emericarhantdev/micro_ROSbot/Specific_symbols_and_footprints/Bulk_polarized_Capacitors/LIB_TCJB227M006R0070/TCJB227M006R0070/3D/TCJB227M006R0070.stp

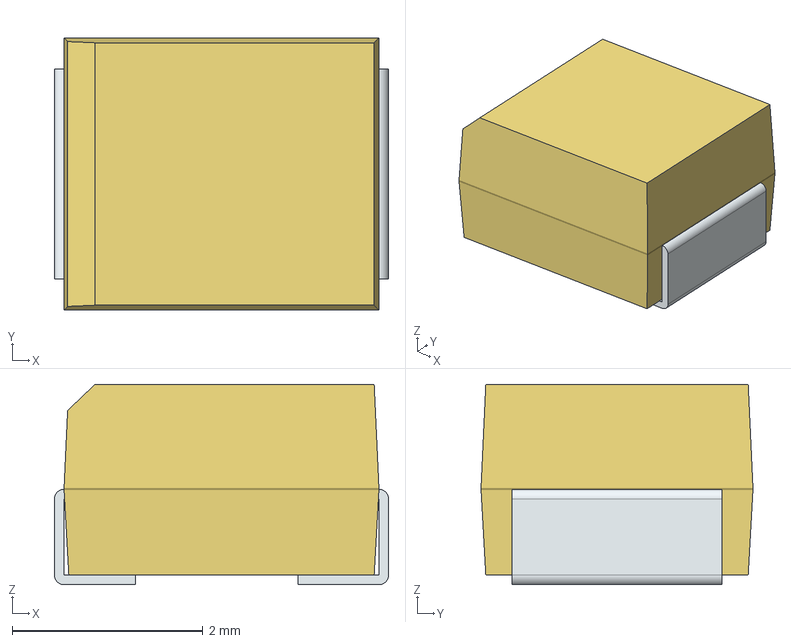
[picture p3: CAD file, 2026-02-18]
Specific_symbols_and_footprints/Bulk_polarized_Capacitors/LIB_TCJB227M006R0070/TCJB227M006R0070/3D/TCJB227M006R0070.stp
3.50 x 2.85 x 2.10 mm
FilletPin1
FilletPin2
