emericarhantdev/micro_ROSbot/Specific_symbols_and_footprints/Buzzers/LIB_CMT-0525-75-SMT-TR/CMT-0525-75-SMT-TR/3D/CMT-0525-75-SMT-TR.stp

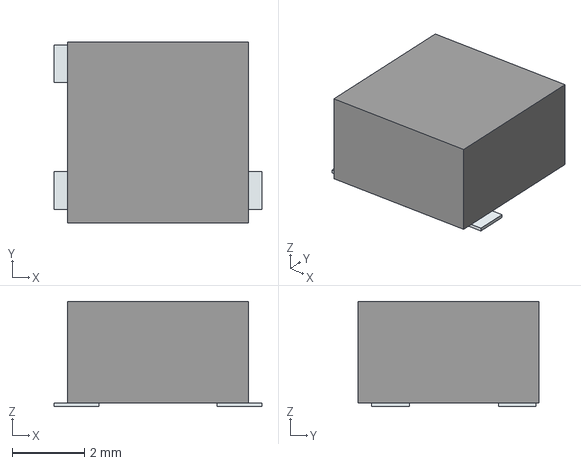
[picture p4: CAD file, 2026-02-18]
Specific_symbols_and_footprints/Buzzers/LIB_CMT-0525-75-SMT-TR/CMT-0525-75-SMT-TR/3D/CMT-0525-75-SMT-TR.stp
5.74 x 5.00 x 2.90 mm
Pins
