emericarhantdev/micro_ROSbot/Specific_symbols_and_footprints/esp32/LIB_ESP32-S3-WROOM-1-N16R8/ESP32-S3-WROOM-1-N16R8/3D/ESP32-S3-WROOM-1-N16R8.stp

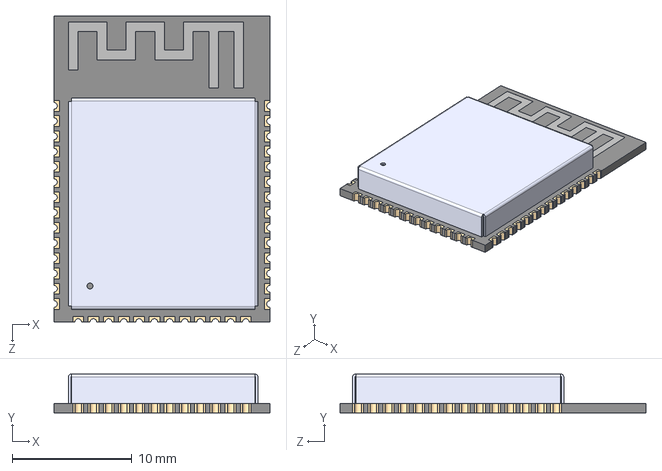
[picture p5: CAD file, 2026-02-18]
Specific_symbols_and_footprints/esp32/LIB_ESP32-S3-WROOM-1-N16R8/ESP32-S3-WROOM-1-N16R8/3D/ESP32-S3-WROOM-1-N16R8.stp
18.0 x 3.25 x 25.5 mm
