emericarhantdev/micro_ROSbot/Specific_symbols_and_footprints/IMUs/LIB_MPU-6050/MPU-6050/3D/MPU-6050.stp

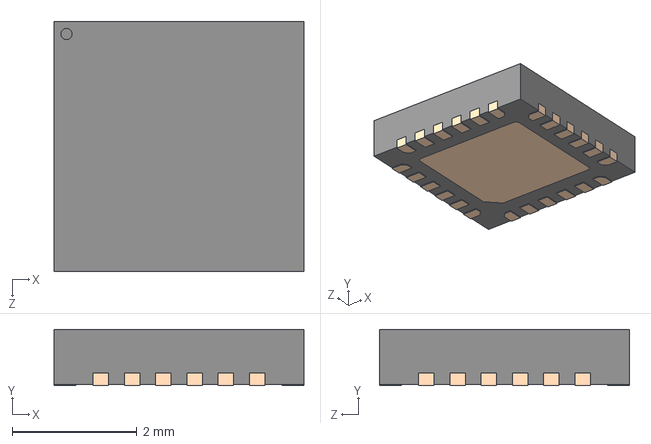
[picture p6: CAD file, 2026-02-18]
Specific_symbols_and_footprints/IMUs/LIB_MPU-6050/MPU-6050/3D/MPU-6050.stp
4.00 x 0.9 x 4.00 mm
