emericarhantdev/micro_ROSbot/Specific_symbols_and_footprints/IR_emiters/LIB_TSAL6200/TSAL6200/3D/TSAL6200.stp

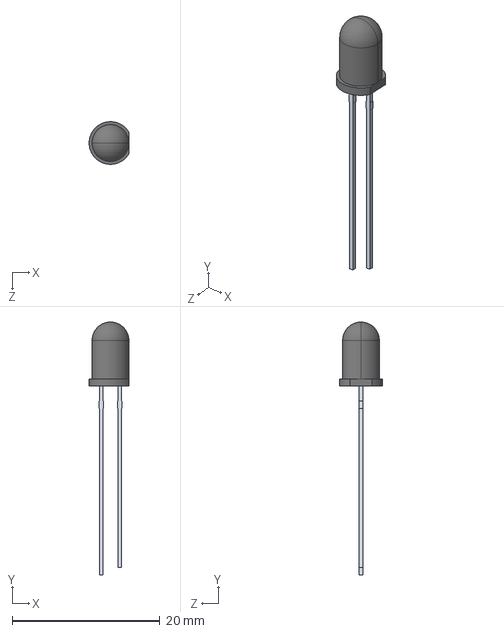
[picture p7: CAD file, 2026-02-18]
Specific_symbols_and_footprints/IR_emiters/LIB_TSAL6200/TSAL6200/3D/TSAL6200.stp
5.40 x 34.3 x 5.79 mm
