emericarhantdev/micro_ROSbot/Specific_symbols_and_footprints/LEDs/LIB_ASCKCG00-NW5X5020302/ASCKCG00-NW5X5020302/3D/ASCKCG00-NW5X5020302.stp

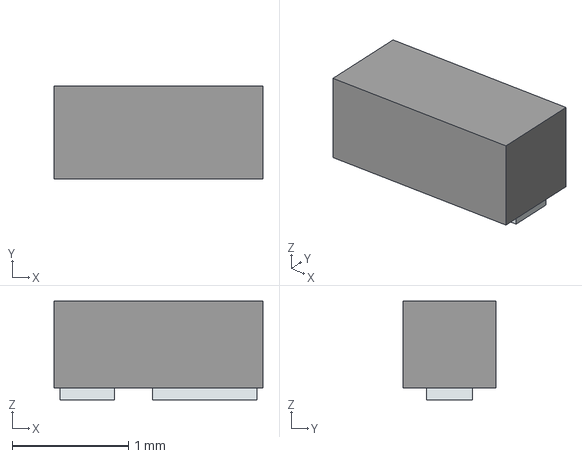
[picture p8: CAD file, 2026-02-18]
Specific_symbols_and_footprints/LEDs/LIB_ASCKCG00-NW5X5020302/ASCKCG00-NW5X5020302/3D/ASCKCG00-NW5X5020302.stp
1.80 x 0.8 x 0.85 mm
Pins
