emericarhantdev/micro_ROSbot/Specific_symbols_and_footprints/Mosfet_transistor/LIB_DMN3065LW-7/DMN3065LW-7/3D/DMN3065LW-7.stp

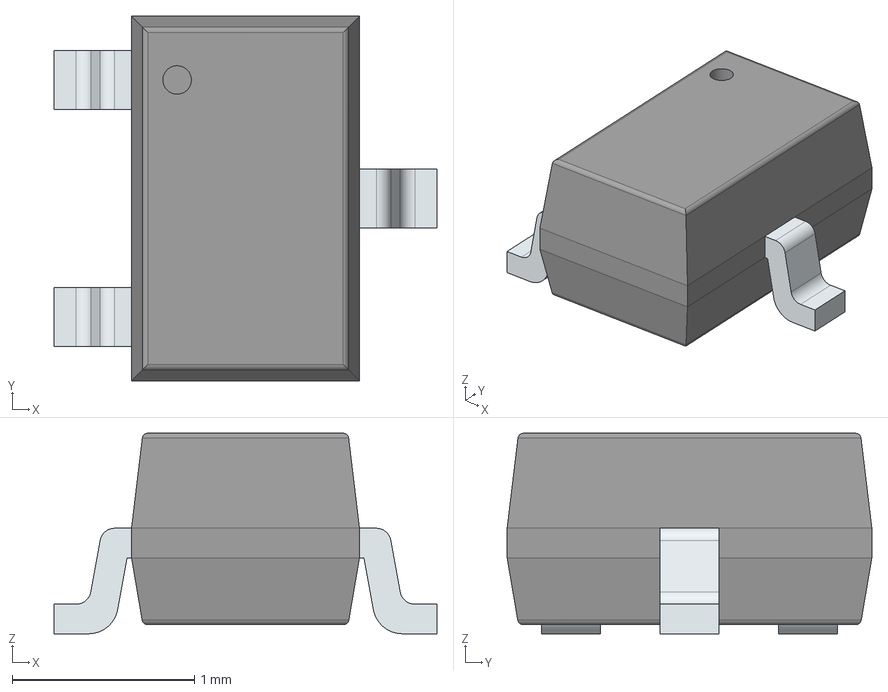
[picture p9: CAD file, 2026-02-18]
Specific_symbols_and_footprints/Mosfet_transistor/LIB_DMN3065LW-7/DMN3065LW-7/3D/DMN3065LW-7.stp
2.10 x 2.00 x 1.10 mm
PinsArrayL
FilletPinR
