emericarhantdev/micro_ROSbot/Specific_symbols_and_footprints/motor_drivers/LIB_TB6612FNG,C,8,EL/TB6612FNG,C,8,EL/3D/TB6612FNG,C,8,EL.stp

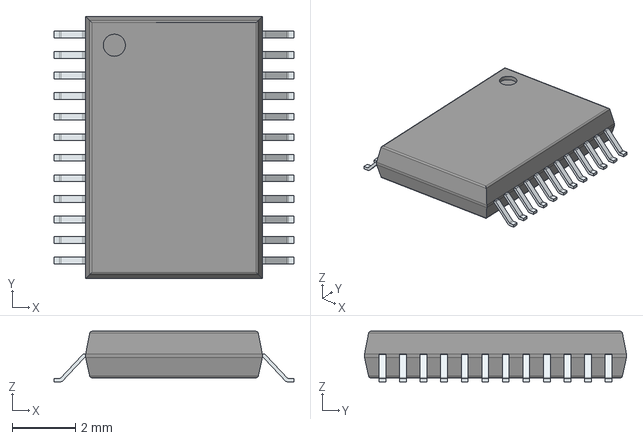
[picture p10: CAD file, 2026-02-18]
Specific_symbols_and_footprints/motor_drivers/LIB_TB6612FNG,C,8,EL/TB6612FNG,C,8,EL/3D/TB6612FNG,C,8,EL.stp
7.60 x 8.30 x 1.60 mm
PinsArrayLR
