emericarhantdev/micro_ROSbot/Specific_symbols_and_footprints/Push_buttons/PTS810SJG250SMTRLFS.stp

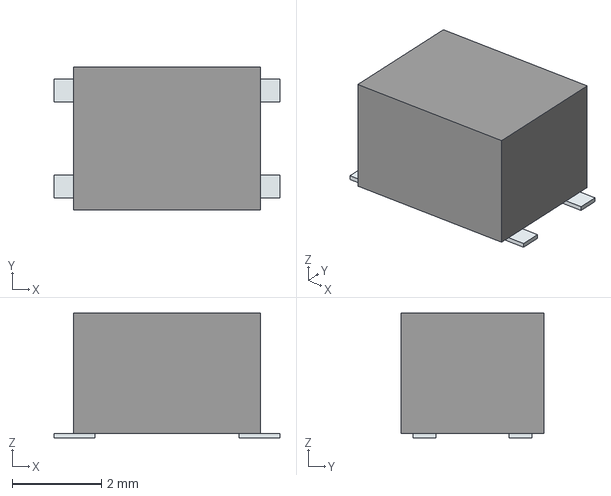
[picture p11: CAD file, 2026-02-18]
Specific_symbols_and_footprints/Push_buttons/PTS810SJG250SMTRLFS.stp
5.07 x 3.20 x 2.80 mm
Pins
