emericarhantdev/micro_ROSbot/Specific_symbols_and_footprints/relays/LIB_IMB03ITS/IMB03ITS/3D/IMB03ITS.stp

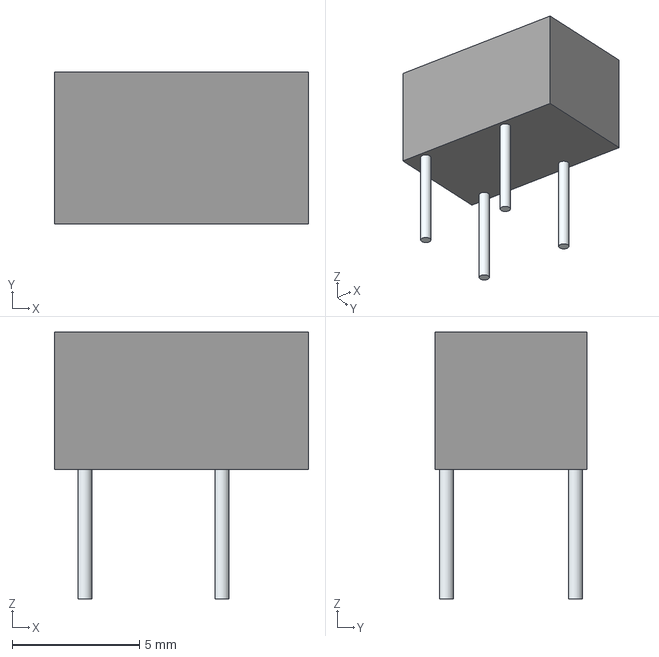
[picture p12: CAD file, 2026-02-18]
Specific_symbols_and_footprints/relays/LIB_IMB03ITS/IMB03ITS/3D/IMB03ITS.stp
10.0 x 6.00 x 10.5 mm
Leads
