emericarhantdev/micro_ROSbot/Specific_symbols_and_footprints/shottky_diodes/LIB_BAT20JFILM/BAT20JFILM/3D/BAT20JFILM.stp

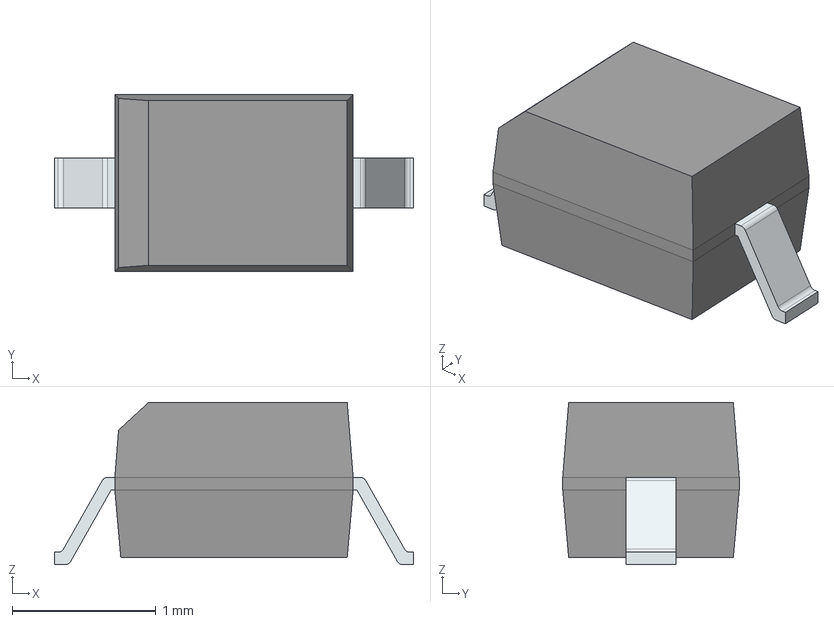
[picture p13: CAD file, 2026-02-18]
Specific_symbols_and_footprints/shottky_diodes/LIB_BAT20JFILM/BAT20JFILM/3D/BAT20JFILM.stp
2.50 x 1.23 x 1.13 mm
FilletPinL
FilletPinR
