emericarhantdev/micro_ROSbot/Specific_symbols_and_footprints/Switch_buttons/LIB_SS312SAH4/SS312SAH4/3D/SS312SAH4.stp

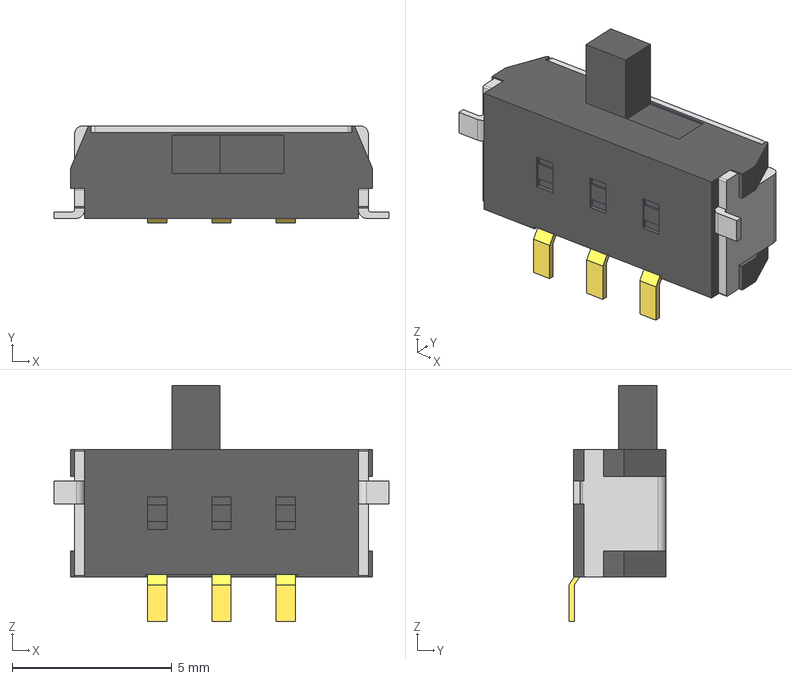
[picture p14: CAD file, 2026-02-18]
Specific_symbols_and_footprints/Switch_buttons/LIB_SS312SAH4/SS312SAH4/3D/SS312SAH4.stp
10.5 x 3.05 x 7.39 mm
SS312SAH4body
SS312SAH4actu
SS312SAH4trmnls
SS312SAH4brac
