emericarhantdev/micro_ROSbot/Specific_symbols_and_footprints/Test_hooks/LIB_S2751-46R/S2751-46R/3D/S2751-46R.stp

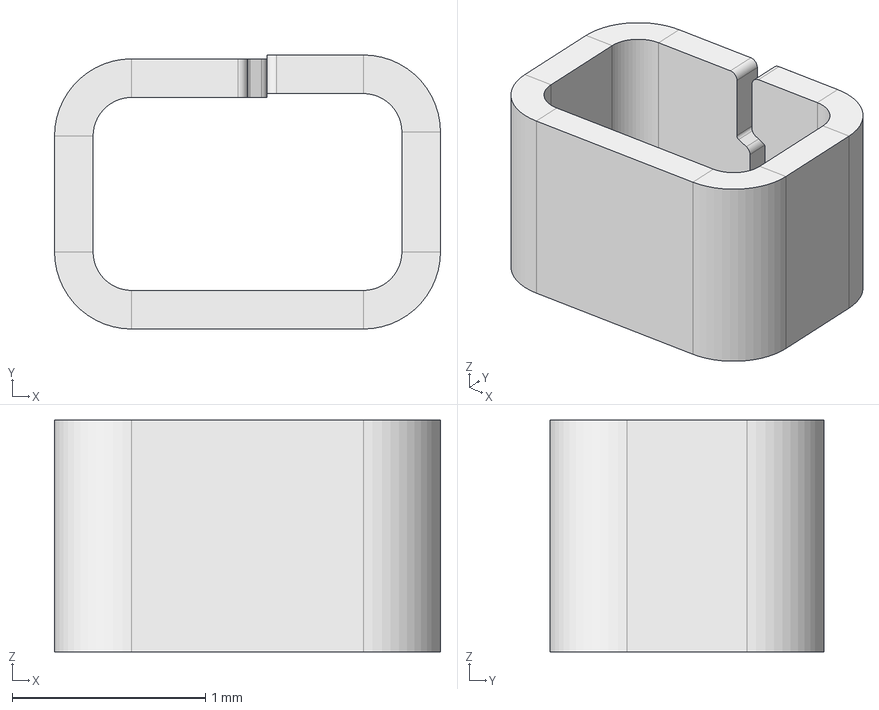
[picture p15: CAD file, 2026-02-18]
Specific_symbols_and_footprints/Test_hooks/LIB_S2751-46R/S2751-46R/3D/S2751-46R.stp
2.00 x 1.42 x 1.20 mm
