emericarhantdev/micro_ROSbot/Specific_symbols_and_footprints/USB_dongles/LIB_USB3075-30-A/USB3075-30-A/3D/USB3075-30-A.stp

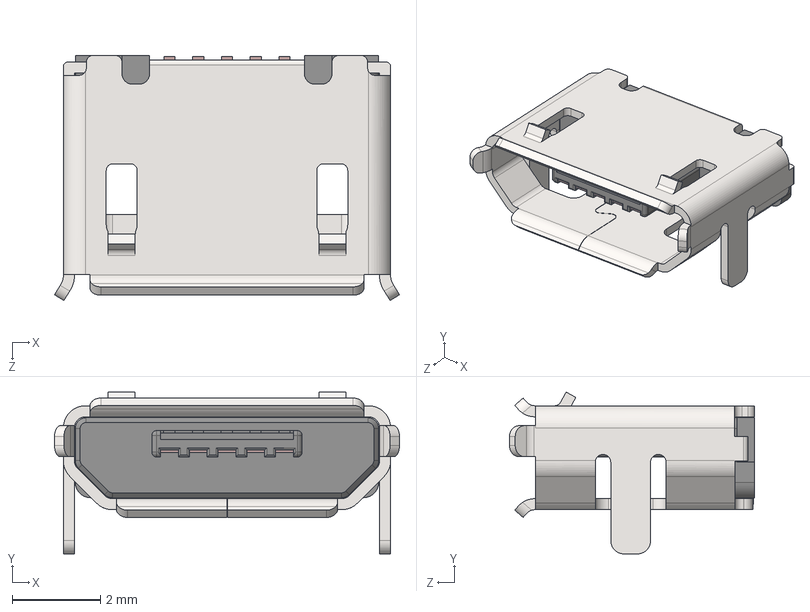
[picture p16: CAD file, 2026-02-18]
Specific_symbols_and_footprints/USB_dongles/LIB_USB3075-30-A/USB3075-30-A/3D/USB3075-30-A.stp
7.80 x 3.66 x 5.54 mm
