emericarhantdev/micro_ROSbot/Specific_symbols_and_footprints/voltage_regulators/LIB_TLV76701DGNR/TLV76701DGNR/3D/TLV76701DGNR.stp

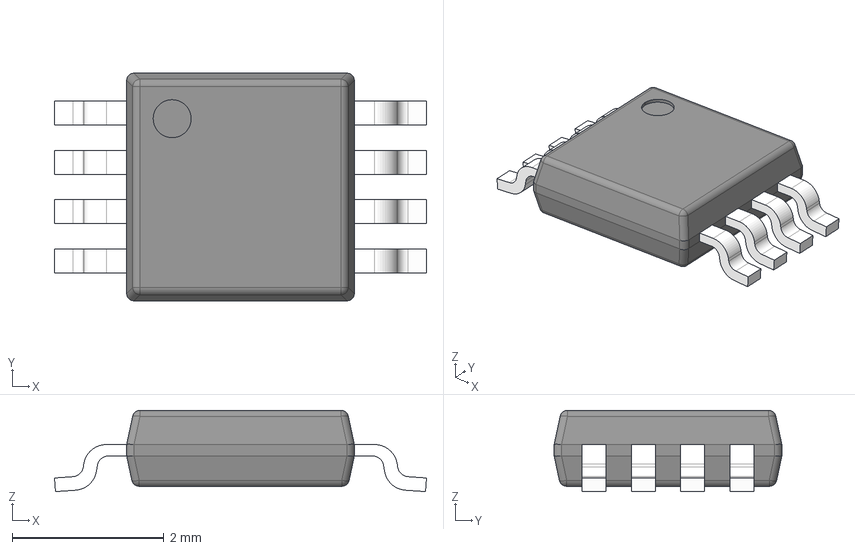
[picture p17: CAD file, 2026-02-18]
Specific_symbols_and_footprints/voltage_regulators/LIB_TLV76701DGNR/TLV76701DGNR/3D/TLV76701DGNR.stp
4.90 x 3.00 x 1.07 mm
BODY-DGN0008G
LEAD-DGN0008G x 8
PIN1_DGN0008G
DAP_DGN0008G
