emericarhantdev/micro_ROSbot/(list of files, cad)

Other CAD files:
Specific_symbols_and_footprints/Bulk_polarized_Capacitors/LIB_TCJB227M006R0070/TCJB227M006R0070/Allegro/cappm3528x210n.psm
Specific_symbols_and_footprints/Bulk_polarized_Capacitors/LIB_TCJB227M006R0070/TCJB227M006R0070/DEHDL/tcjb227m006r0070/chips/chips.prt
Specific_symbols_and_footprints/Buzzers/LIB_CMT-0525-75-SMT-TR/CMT-0525-75-SMT-TR/Allegro/cmt052575smttr.psm
Specific_symbols_and_footprints/Buzzers/LIB_CMT-0525-75-SMT-TR/CMT-0525-75-SMT-TR/DEHDL/cmt_0525_75_smt_tr/chips/chips.prt
Specific_symbols_and_footprints/IMUs/LIB_MPU-6050/MPU-6050/Allegro/mpu6050.psm
Specific_symbols_and_footprints/IMUs/LIB_MPU-6050/MPU-6050/DEHDL/mpu_6050/chips/chips.prt
Specific_symbols_and_footprints/IR_emiters/LIB_TSAL6200/TSAL6200/Allegro/tsal6200.psm
Specific_symbols_and_footprints/IR_emiters/LIB_TSAL6200/TSAL6200/DEHDL/tsal6200/chips/chips.prt
Specific_symbols_and_footprints/LEDs/LIB_ASCKCG00-NW5X5020302/ASCKCG00-NW5X5020302/Allegro/asckcg00nw5x5020302.psm
Specific_symbols_and_footprints/LEDs/LIB_ASCKCG00-NW5X5020302/ASCKCG00-NW5X5020302/DEHDL/asckcg00_nw5x5020302/chips/chips.prt
Specific_symbols_and_footprints/Mosfet_transistor/LIB_DMN3065LW-7/DMN3065LW-7/Allegro/sot65p210x110-3n.psm
Specific_symbols_and_footprints/Mosfet_transistor/LIB_DMN3065LW-7/DMN3065LW-7/DEHDL/dmn3065lw_7/chips/chips.prt
Specific_symbols_and_footprints/Push_buttons/LIB_PTS810SJM250SMTRLFS/PTS810SJM250SMTRLFS/Allegro/pts810sjg250smtrlfs.psm
Specific_symbols_and_footprints/Push_buttons/LIB_PTS810SJM250SMTRLFS/PTS810SJM250SMTRLFS/DEHDL/pts810sjm250smtrlfs/chips/chips.prt
Specific_symbols_and_footprints/Switch_buttons/LIB_SS312SAH4/SS312SAH4/Allegro/ss312sah4.psm
Specific_symbols_and_footprints/Switch_buttons/LIB_SS312SAH4/SS312SAH4/DEHDL/ss312sah4/chips/chips.prt
Specific_symbols_and_footprints/Test_hooks/LIB_S2751-46R/S2751-46R/Allegro/s275146r.psm
Specific_symbols_and_footprints/Test_hooks/LIB_S2751-46R/S2751-46R/DEHDL/s2751_46r/chips/chips.prt
Specific_symbols_and_footprints/USB_dongles/LIB_USB3075-30-A/USB3075-30-A/Allegro/usb307530a.psm
Specific_symbols_and_footprints/USB_dongles/LIB_USB3075-30-A/USB3075-30-A/DEHDL/usb3075_30_a/chips/chips.prt
Specific_symbols_and_footprints/esp32/LIB_ESP32-S3-WROOM-1-N16R8/ESP32-S3-WROOM-1-N16R8/Allegro/esp32s3wroom1n16r8.psm
Specific_symbols_and_footprints/esp32/LIB_ESP32-S3-WROOM-1-N16R8/ESP32-S3-WROOM-1-N16R8/DEHDL/esp32_s3_wroom_1_n16r8/chips/chips.prt
Specific_symbols_and_footprints/motor_drivers/LIB_TB6612FNG,C,8,EL/TB6612FNG,C,8,EL/Allegro/sop65p760x160-24n.psm
Specific_symbols_and_footprints/motor_drivers/LIB_TB6612FNG,C,8,EL/TB6612FNG,C,8,EL/DEHDL/tb6612fng_c_8_el/chips/chips.prt
Specific_symbols_and_footprints/relays/LIB_IMB03ITS/IMB03ITS/Allegro/imb03its.psm
Specific_symbols_and_footprints/relays/LIB_IMB03ITS/IMB03ITS/DEHDL/imb03its/chips/chips.prt
Specific_symbols_and_footprints/shottky_diodes/LIB_BAT20JFILM/BAT20JFILM/Allegro/sod2512x113n.psm
Specific_symbols_and_footprints/shottky_diodes/LIB_BAT20JFILM/BAT20JFILM/DEHDL/bat20jfilm/chips/chips.prt
Specific_symbols_and_footprints/voltage_regulators/LIB_TLV76701DGNR/TLV76701DGNR/Allegro/sop65p490x110-9n.psm
Specific_symbols_and_footprints/voltage_regulators/LIB_TLV76701DGNR/TLV76701DGNR/DEHDL/tlv76701dgnr/chips/chips.prt
