emericarhantdev/micro_ROSbot/PAMI-Power_Board.kicad_pcb

## KiCad design PAMI-Power_Board.kicad_pcb (2026-02-18)

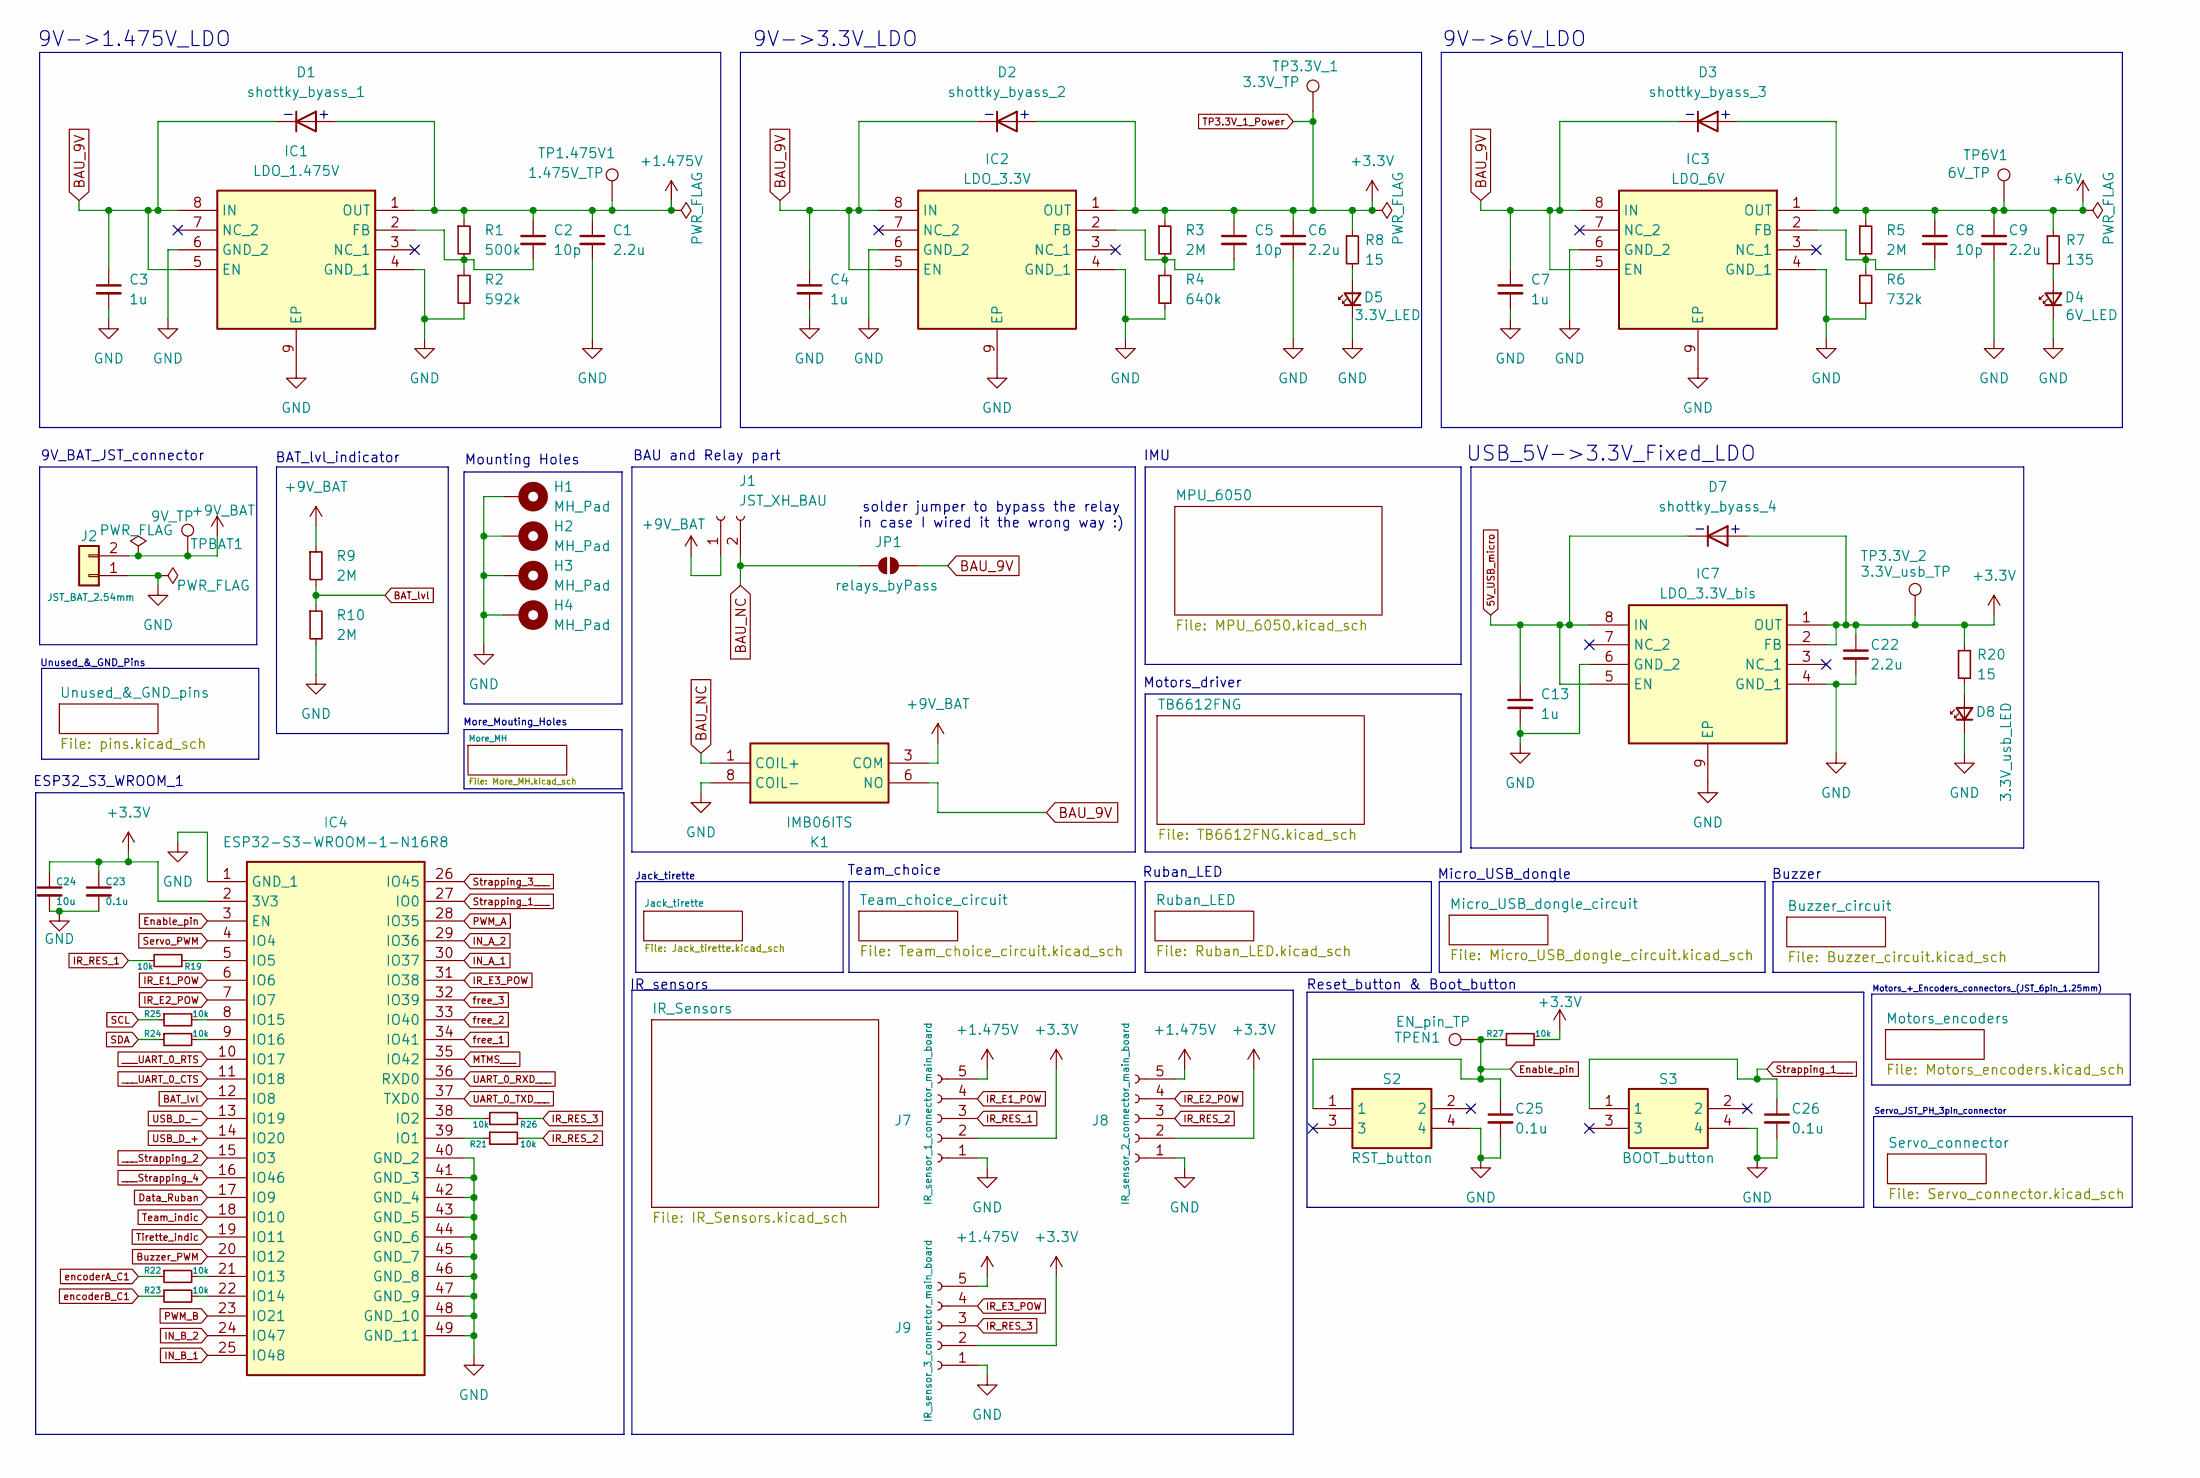
[picture p18: schematic PAMI-Power_Board.kicad_sch]

Parts:
C1, C6, C9, C22: 2.2u; C_0805_2012Metric_Pad1.18x1.45mm_HandSolder
C2, C5, C8: 10p; C_0805_2012Metric_Pad1.18x1.45mm_HandSolder
C3, C4, C7, C13: 1u; C_0805_2012Metric_Pad1.18x1.45mm_HandSolder
C23, C25, C26: 0.1u; C_0805_2012Metric_Pad1.18x1.45mm_HandSolder
C24: 10u; C_0805_2012Metric_Pad1.18x1.45mm_HandSolder
D1: shottky_byass_1; SOD2512X113N
D2: shottky_byass_2; SOD2512X113N
D3: shottky_byass_3; SOD2512X113N
D4: 6V_LED; ASCKCG00NW5X5020302
D5: 3.3V_LED; ASCKCG00NW5X5020302
D7: shottky_byass_4; SOD2512X113N
D8: 3.3V_usb_LED; ASCKCG00NW5X5020302
H1, H2, H3, H4: MH_Pad; MountingHole_2.2mm_M2_Pad_Via
IC1: LDO_1.475V; SOP65P490X110-9N; Manufacturer_Part_Number TLV76701DGNR; Mouser Part Number 595-TLV76701DGNR
IC2: LDO_3.3V; SOP65P490X110-9N; Manufacturer_Part_Number TLV76701DGNR; Mouser Part Number 595-TLV76701DGNR
IC3: LDO_6V; SOP65P490X110-9N; Manufacturer_Part_Number TLV76701DGNR; Mouser Part Number 595-TLV76701DGNR
IC4: ESP32-S3-WROOM-1-N16R8; ESP32S3WROOM1N16R8; Manufacturer_Part_Number ESP32-S3-WROOM-1-N16R8; Mouser Part Number 356-ESP32S3WRM1N16R8
IC7: LDO_3.3V_bis; SOP65P490X110-9N; Manufacturer_Part_Number TLV76701DGNR; Mouser Part Number 595-TLV76701DGNR
J1: JST_XH_BAU; JST_XH_B2B-XH-A_1x02_P2.50mm_Vertical
J2: JST_BAT_2.54mm; JST_XH_B2B-XH-A_1x02_P2.50mm_Vertical
J7: IR_sensor_1_connector_main_board; JST_ZH_1x05_P1.50mm_Vertical
J8: IR_sensor_2_connector_main_board; JST_ZH_1x05_P1.50mm_Vertical
J9: IR_sensor_3_connector_main_board; JST_ZH_1x05_P1.50mm_Vertical
JP1: relays_byPass; SolderJumper-2_P1.3mm_Open_Pad1.0x1.5mm
K1: IMB06ITS; IMB03ITS; Manufacturer_Part_Number IMB03ITS; Mouser Part Number 655-IMB03ITS
R1: 500k; R_0805_2012Metric_Pad1.20x1.40mm_HandSolder
R2: 592k; R_0805_2012Metric_Pad1.20x1.40mm_HandSolder
R3, R5, R9, R10: 2M; R_0805_2012Metric_Pad1.20x1.40mm_HandSolder
R4: 640k; R_0805_2012Metric_Pad1.20x1.40mm_HandSolder
R6: 732k; R_0805_2012Metric_Pad1.20x1.40mm_HandSolder
R7: 135; R_0805_2012Metric_Pad1.20x1.40mm_HandSolder
R8, R20: 15; R_0805_2012Metric_Pad1.20x1.40mm_HandSolder
R19, R21, R22, R23, R24, R25, R26, R27: 10k; R_0805_2012Metric_Pad1.20x1.40mm_HandSolder
S2: RST_button; PTS810SJG250SMTRLFS; Manufacturer_Part_Number PTS810SJM250SMTRLFS; Mouser Part Number 611-PTS810SJM250SMTR
S3: BOOT_button; PTS810SJG250SMTRLFS; Manufacturer_Part_Number PTS810SJM250SMTRLFS; Mouser Part Number 611-PTS810SJM250SMTR
TP1.475V1: 1.475V_TP; S275146R
TP3.3V_1: 3.3V_TP; S275146R
TP3.3V_2: 3.3V_usb_TP; S275146R
TP6V1: 6V_TP; S275146R
TPBAT1: 9V_TP; S275146R
TPEN1: EN_pin_TP; S275146R

Connections:
5V_USB_micro: C13.1, D7.1 (K), IC7.5 (EN), IC7.8 (IN); also elsewhere on the board
+1.475V: C1.1, C2.1, D1.2 (A), IC1.1 (OUT), J7.5, J8.5, J9.5, R1.1, TP1.475V1.1; also elsewhere on the board
+6V: C8.1, C9.1, D3.2 (A), IC3.1 (OUT), R5.1, R7.1, TP6V1.1; also elsewhere on the board
+9V_BAT: J1.1, J2.2, K1.3 (COM), R9.1, TPBAT1.1
BAT_lvl: IC4.12 (IO8), R9.2, R10.1
BAU_9V: C3.1, C4.1, C7.1, D1.1 (K), D2.1 (K), D3.1 (K), IC1.5 (EN), IC1.8 (IN), IC2.5 (EN), IC2.8 (IN), IC3.5 (EN), IC3.8 (IN), JP1.2 (B), K1.6 (NO)
BAU_NC: J1.2, JP1.1 (A), K1.1 (COIL+)
Buzzer_PWM: IC4.20 (IO12); also elsewhere on the board
Data_Ruban: IC4.17 (IO9); also elsewhere on the board
Enable_pin: C25.1, IC4.3 (EN), R27.1, S2.1, TPEN1.1
GND: C1.2, C3.2, C4.2, C6.2, C7.2, C9.2, C13.2, C22.2, C23.2, C24.2, C25.2, C26.2, D4.1 (K), D5.1 (K), D8.1 (K), H1.1, H2.1, H3.1, H4.1, IC1.4 (GND_1), IC1.6 (GND_2), IC1.9 (EP), IC2.4 (GND_1), IC2.6 (GND_2), IC2.9 (EP), IC3.4 (GND_1), IC3.6 (GND_2), IC3.9 (EP), IC4.1 (GND_1), IC4.40 (GND_2), IC4.41 (GND_3), IC4.42 (GND_4), IC4.43 (GND_5), IC4.44 (GND_6), IC4.45 (GND_7), IC4.46 (GND_8), IC4.47 (GND_9), IC4.48 (GND_10), IC4.49 (GND_11), IC7.4 (GND_1), IC7.6 (GND_2), IC7.9 (EP), J2.1, J7.1, J8.1, J9.1, K1.8 (COIL-), R2.2, R4.2, R6.2, R10.2, S2.4, S3.4; also elsewhere on the board
IN_A_1: IC4.30 (IO37); also elsewhere on the board
IN_A_2: IC4.29 (IO36); also elsewhere on the board
IN_B_1: IC4.25 (IO48); also elsewhere on the board
IN_B_2: IC4.24 (IO47); also elsewhere on the board
IR_E1_POW: IC4.6 (IO6), J7.4; also elsewhere on the board
IR_E2_POW: IC4.7 (IO7), J8.4; also elsewhere on the board
IR_E3_POW: IC4.31 (IO38), J9.4; also elsewhere on the board
IR_RES_1: J7.3, R19.2; also elsewhere on the board
IR_RES_2: J8.3, R21.2; also elsewhere on the board
IR_RES_3: J9.3, R26.1; also elsewhere on the board
MTMS___: IC4.35 (IO42); also elsewhere on the board
unnamed: D4.2 (A), R7.2
unnamed: D5.2 (A), R8.2
unnamed: D8.2 (A), R20.2
unnamed: C2.2, IC1.2 (FB), R1.2, R2.1
unnamed: C5.2, IC2.2 (FB), R3.2, R4.1
unnamed: C8.2, IC3.2 (FB), R5.2, R6.1
unnamed: IC4.39 (IO1), R21.1
unnamed: IC4.38 (IO2), R26.2
unnamed: IC4.5 (IO5), R19.1
unnamed: IC4.21 (IO13), R22.2
unnamed: IC4.22 (IO14), R23.2
unnamed: IC4.8 (IO15), R25.2
unnamed: IC4.9 (IO16), R24.2
PWM_A: IC4.28 (IO35); also elsewhere on the board
PWM_B: IC4.23 (IO21); also elsewhere on the board
SCL: R25.1; also elsewhere on the board
SDA: R24.1; also elsewhere on the board
Servo_PWM: IC4.4 (IO4); also elsewhere on the board
Strapping_1___: C26.1, IC4.27 (IO0), S3.1
Strapping_3___: IC4.26 (IO45); also elsewhere on the board
TP3.3V_1_Power: C5.1, C6.1, C22.1, C23.1, C24.1, D2.2 (A), D7.2 (A), IC2.1 (OUT), IC4.2 (3V3), IC7.1 (OUT), IC7.2 (FB), J7.2, J8.2, J9.2, R3.1, R8.1, R20.1, R27.2, TP3.3V_1.1, TP3.3V_2.1; also elsewhere on the board
Team_indic: IC4.18 (IO10); also elsewhere on the board
Tirette_indic: IC4.19 (IO11); also elsewhere on the board
UART_0_RXD___: IC4.36 (RXD0); also elsewhere on the board
UART_0_TXD___: IC4.37 (TXD0); also elsewhere on the board
USB_D_+: IC4.14 (IO20); also elsewhere on the board
USB_D_-: IC4.13 (IO19); also elsewhere on the board
___Strapping_2: IC4.15 (IO3); also elsewhere on the board
___Strapping_4: IC4.16 (IO46); also elsewhere on the board
___UART_0_CTS: IC4.11 (IO18); also elsewhere on the board
___UART_0_RTS: IC4.10 (IO17); also elsewhere on the board
encoderA_C1: R22.1; also elsewhere on the board
encoderB_C1: R23.1; also elsewhere on the board
free_1: IC4.34 (IO41); also elsewhere on the board
free_2: IC4.33 (IO40); also elsewhere on the board
free_3: IC4.32 (IO39); also elsewhere on the board

Notes on the sheet:
9V->6V_LDO
Motors_driver
USB_5V->3.3V_Fixed_LDO
Servo_JST_PH_3pin_connector
solder jumper to bypass the relay in case I wired it the wrong way :)
Ruban_LED
BAU and Relay part
IR_sensors
9V->1.475V_LDO
IMU
9V_BAT_JST_connector
Team_choice
ESP32_S3_WROOM_1
Jack_tirette
Motors_+_Encoders_connectors_(JST_6pin_1.25mm)
Mounting Holes
9V->3.3V_LDO
Micro_USB_dongle
BAT_lvl_indicator
Buzzer
More_Mouting_Holes
Unused_&_GND_Pins
Reset_button & Boot_button

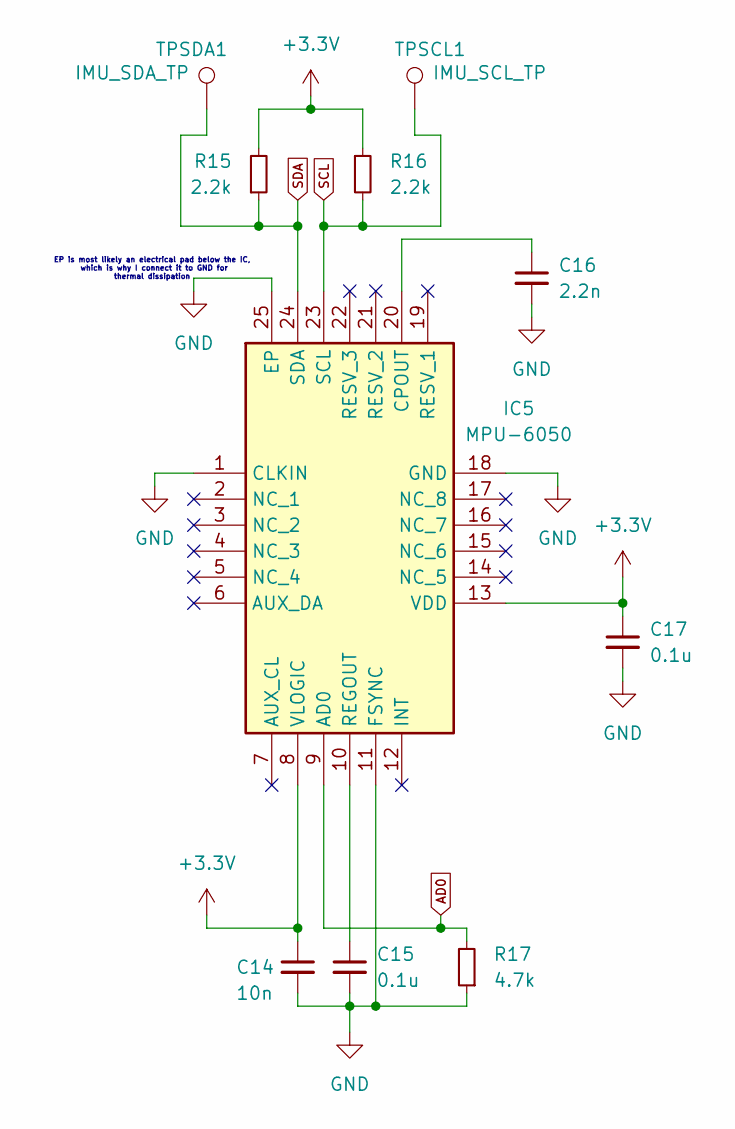
[picture p19: schematic MPU_6050.kicad_sch]

Parts:
C14: 10n; C_0805_2012Metric_Pad1.18x1.45mm_HandSolder
C15, C17: 0.1u; C_0805_2012Metric_Pad1.18x1.45mm_HandSolder
C16: 2.2n; C_0805_2012Metric_Pad1.18x1.45mm_HandSolder
IC5: MPU-6050; MPU6050; Manufacturer_Part_Number MPU-6050; Mouser Part Number 410-MPU-6050
R15, R16: 2.2k; R_0805_2012Metric_Pad1.20x1.40mm_HandSolder
R17: 4.7k; R_0805_2012Metric_Pad1.20x1.40mm_HandSolder
TPSCL1: IMU_SCL_TP; S275146R
TPSDA1: IMU_SDA_TP; S275146R

Connections:
AD0: IC5.9 (AD0), R17.2
GND: C14.2, C15.2, C16.2, C17.2, IC5.1 (CLKIN), IC5.11 (FSYNC), IC5.18 (GND), IC5.25 (EP), R17.1; also elsewhere on the board
unnamed: C16.1, IC5.20 (CPOUT)
unnamed: C15.1, IC5.10 (REGOUT)
SCL: IC5.23 (SCL), R16.2, TPSCL1.1; also elsewhere on the board
SDA: IC5.24 (SDA), R15.1, TPSDA1.1; also elsewhere on the board
TP3.3V_1_Power: C14.1, C17.1, IC5.8 (VLOGIC), IC5.13 (VDD), R15.2, R16.1; also elsewhere on the board

Notes on the sheet:
EP is most likely an electrical pad below the IC, which is why I connect it to GND for thermal dissipation

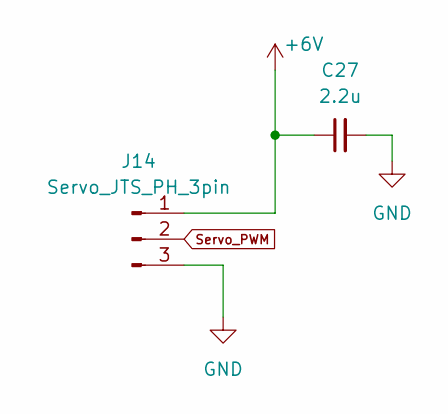
[picture p20: schematic Servo_connector.kicad_sch]

Parts:
C27: 2.2u; C_0805_2012Metric_Pad1.18x1.45mm_HandSolder
J14: Servo_JTS_PH_3pin; JST_PH_B3B-PH-K_1x03_P2.00mm_Vertical

Connections:
+6V: C27.1, J14.1; also elsewhere on the board
GND: C27.2, J14.3; also elsewhere on the board
Servo_PWM: J14.2; also elsewhere on the board

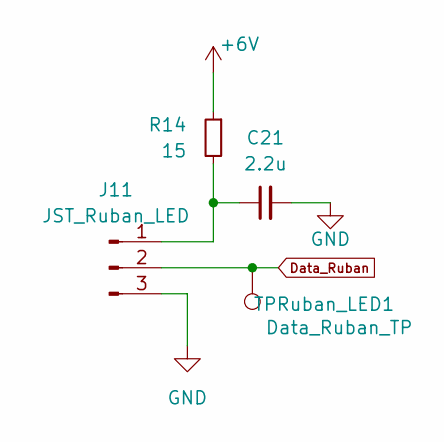
[picture p21: schematic Ruban_LED.kicad_sch]

Parts:
C21: 2.2u; C_0805_2012Metric_Pad1.18x1.45mm_HandSolder
J11: JST_Ruban_LED; JST_PH_B3B-PH-K_1x03_P2.00mm_Vertical
R14: 15; R_0805_2012Metric_Pad1.20x1.40mm_HandSolder
TPRuban_LED1: Data_Ruban_TP; S275146R

Connections:
+6V: R14.1; also elsewhere on the board
Data_Ruban: J11.2, TPRuban_LED1.1; also elsewhere on the board
GND: C21.2, J11.3; also elsewhere on the board
unnamed: C21.1, J11.1, R14.2

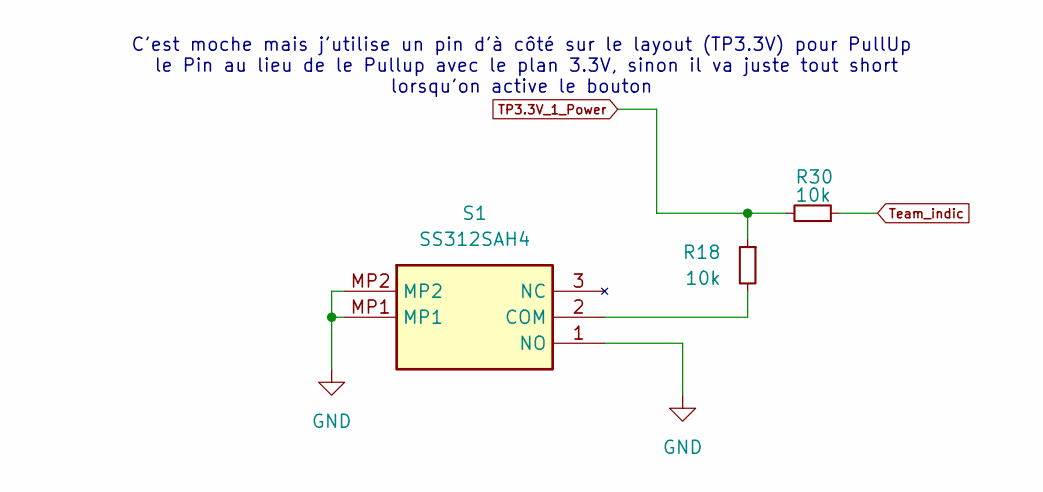
[picture p22: schematic Team_choice_circuit.kicad_sch]

Parts:
R18, R30: 10k; R_0805_2012Metric_Pad1.20x1.40mm_HandSolder
S1: SS312SAH4; Manufacturer_Part_Number SS312SAH4; Mouser Part Number 633-SS312SAH4

Connections:
GND: S1.1 (NO), S1.MP1, S1.MP2; also elsewhere on the board
unnamed: R18.2, S1.2 (COM)
TP3.3V_1_Power: R18.1, R30.2; also elsewhere on the board
Team_indic: R30.1; also elsewhere on the board

Notes on the sheet:
C'est moche mais j'utilise un pin d'à côté sur le layout (TP3.3V) pour PullUp le Pin au lieu de le Pullup avec le plan 3.3V, sinon il va juste tout short lorsqu'on active le bouton

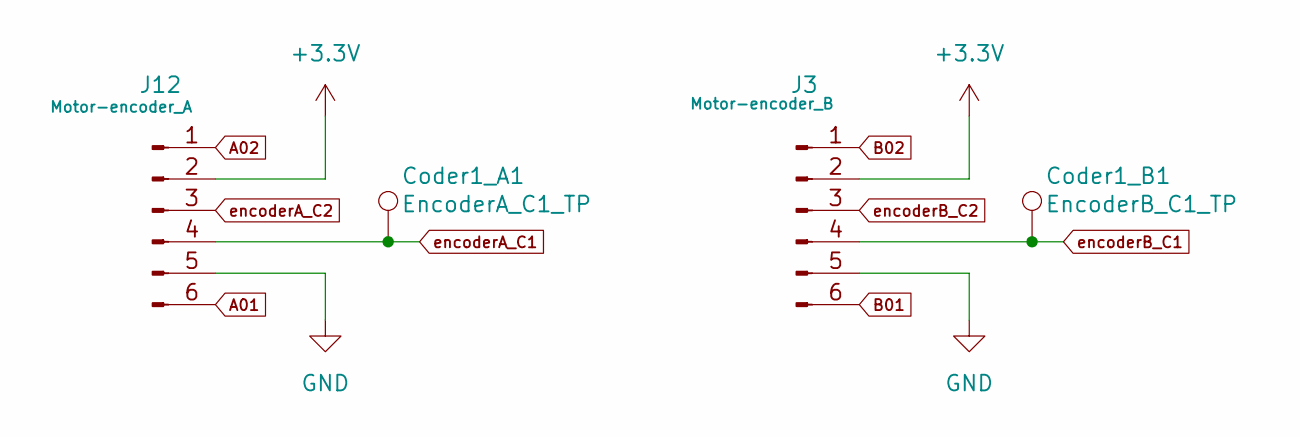
[picture p23: schematic Motors_encoders.kicad_sch]

Parts:
Coder1_A1: EncoderA_C1_TP; S275146R
Coder1_B1: EncoderB_C1_TP; S275146R
J3: Motor-encoder_B; JST_ZH_1x06_P1.5mm_no_Connector
J12: Motor-encoder_A; JST_ZH_1x06_P1.5mm_no_Connector

Connections:
A01: J12.6; also elsewhere on the board
A02: J12.1; also elsewhere on the board
B01: J3.6; also elsewhere on the board
B02: J3.1; also elsewhere on the board
GND: J3.5, J12.5; also elsewhere on the board
TP3.3V_1_Power: J3.2, J12.2; also elsewhere on the board
encoderA_C1: Coder1_A1.1, J12.4; also elsewhere on the board
encoderA_C2: J12.3
encoderB_C1: Coder1_B1.1, J3.4; also elsewhere on the board
encoderB_C2: J3.3

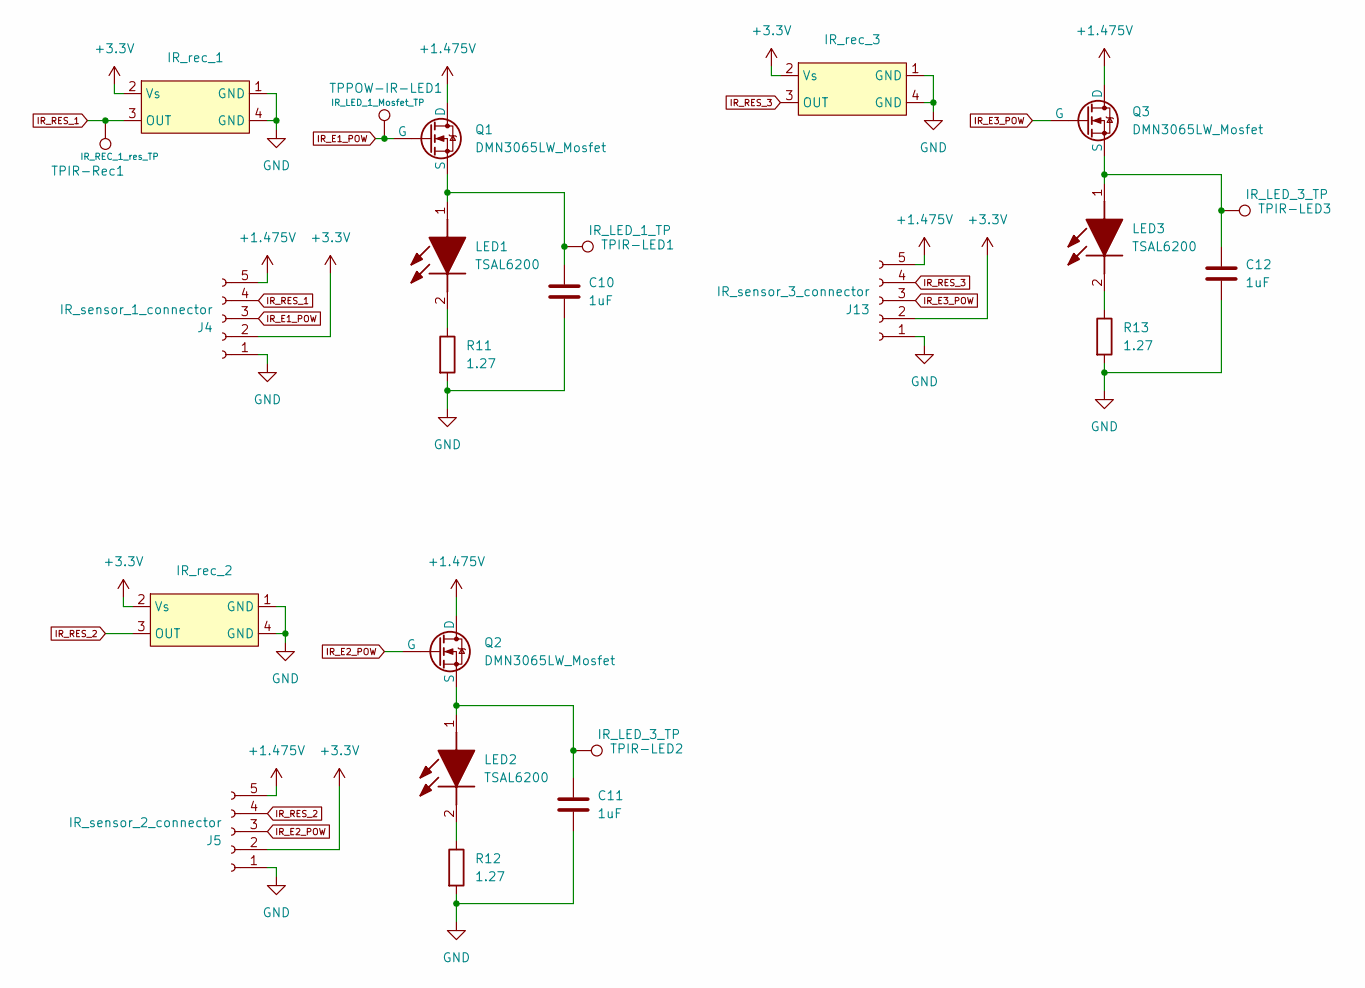
[picture p24: schematic IR_Sensors.kicad_sch]

Parts:
C10, C11, C12: 1uF; C_0805_2012Metric_Pad1.18x1.45mm_HandSolder
IR_rec_1, IR_rec_2, IR_rec_3: IR_receiver_TSSP77038TT
J4: IR_sensor_1_connector; JST_ZH_1x05_P1.50mm_Vertical
J5: IR_sensor_2_connector; JST_ZH_1x05_P1.50mm_Vertical
J13: IR_sensor_3_connector; JST_ZH_1x05_P1.50mm_Vertical
LED1, LED2, LED3: TSAL6200; Manufacturer_Part_Number TSAL6200; Mouser Part Number 782-TSAL6200
Q1, Q2, Q3: DMN3065LW_Mosfet; SOT65P210X110-3N
R11, R12, R13: 1.27; R_0805_2012Metric_Pad1.20x1.40mm_HandSolder
TPIR-LED1: IR_LED_1_TP; S275146R
TPIR-LED2, TPIR-LED3: IR_LED_3_TP; S275146R
TPIR-Rec1: IR_REC_1_res_TP; S275146R
TPPOW-IR-LED1: IR_LED_1_Mosfet_TP; S275146R

Connections:
+1.475V: J4.5, J5.5, J13.5, Q1.1 (D), Q2.1 (D), Q3.1 (D); also elsewhere on the board
GND: C10.2, C11.2, C12.2, IR_rec_1.1 (GND), IR_rec_1.4 (GND), IR_rec_2.1 (GND), IR_rec_2.4 (GND), IR_rec_3.1 (GND), IR_rec_3.4 (GND), J4.1, J5.1, J13.1, R11.2, R12.2, R13.2; also elsewhere on the board
IR_E1_POW: J4.3, Q1.2 (G), TPPOW-IR-LED1.1; also elsewhere on the board
IR_E2_POW: J5.3, Q2.2 (G); also elsewhere on the board
IR_E3_POW: J13.3, Q3.2 (G); also elsewhere on the board
IR_RES_1: IR_rec_1.3 (OUT), J4.4, TPIR-Rec1.1; also elsewhere on the board
IR_RES_2: IR_rec_2.3 (OUT), J5.4; also elsewhere on the board
IR_RES_3: IR_rec_3.3 (OUT), J13.4; also elsewhere on the board
unnamed: C10.1, LED1.1 (A), Q1.3 (S), TPIR-LED1.1
unnamed: LED1.2 (K), R11.1
unnamed: C11.1, LED2.1 (A), Q2.3 (S), TPIR-LED2.1
unnamed: LED2.2 (K), R12.1
unnamed: C12.1, LED3.1 (A), Q3.3 (S), TPIR-LED3.1
unnamed: LED3.2 (K), R13.1
TP3.3V_1_Power: IR_rec_1.2 (Vs), IR_rec_2.2 (Vs), IR_rec_3.2 (Vs), J4.2, J5.2, J13.2; also elsewhere on the board

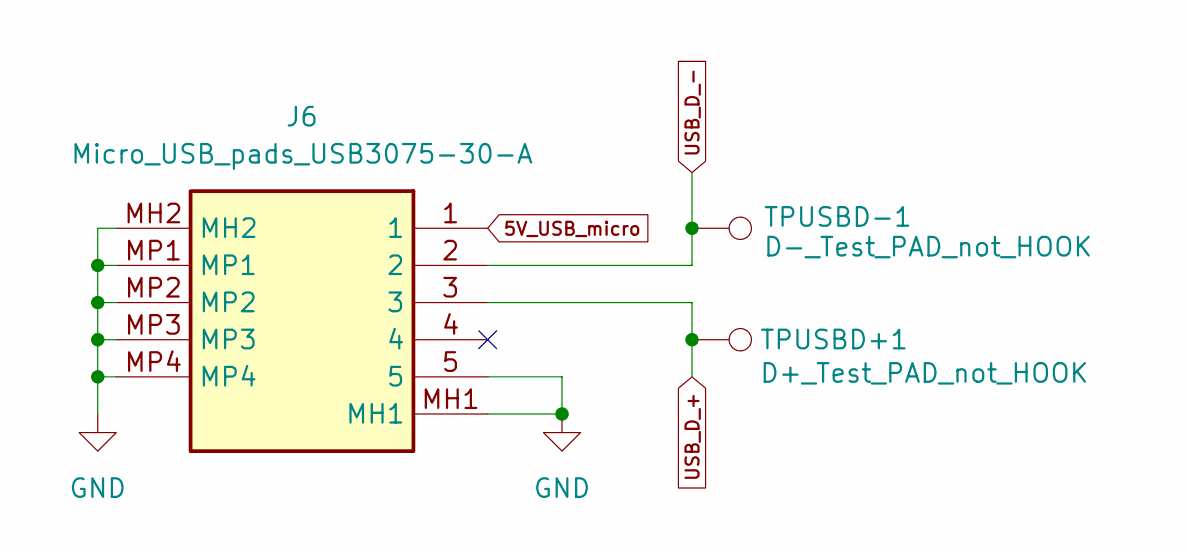
[picture p25: schematic Micro_USB_dongle_circuit.kicad_sch]

Parts:
J6: Micro_USB_pads_USB3075-30-A; USB307530A; Manufacturer_Part_Number USB3075-30-A; Mouser Part Number 640-USB3075-30-A
TPUSBD+1: D+_Test_PAD_not_HOOK; TestPoint_Pad_D2.0mm
TPUSBD-1: D-_Test_PAD_not_HOOK; TestPoint_Pad_D2.0mm

Connections:
5V_USB_micro: J6.1; also elsewhere on the board
GND: J6.5, J6.MH1, J6.MH2, J6.MP1, J6.MP2, J6.MP3, J6.MP4; also elsewhere on the board
USB_D_+: J6.3, TPUSBD+1.1; also elsewhere on the board
USB_D_-: J6.2, TPUSBD-1.1; also elsewhere on the board

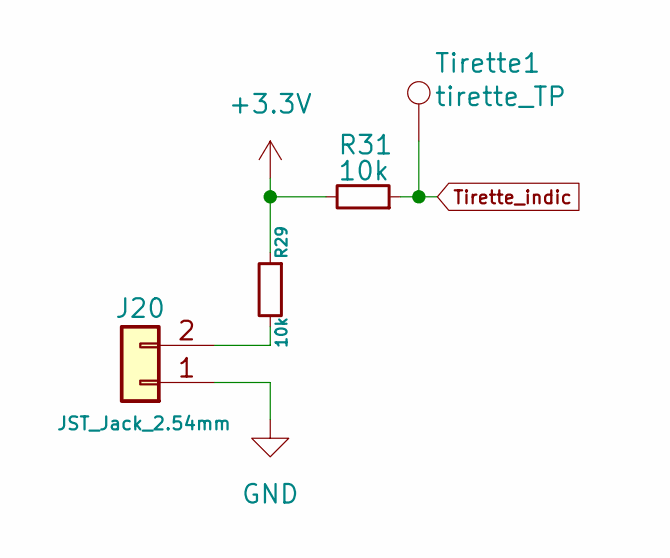
[picture p26: schematic Jack_tirette.kicad_sch]

Parts:
J20: JST_Jack_2.54mm; JST_XH_B2B-XH-A_1x02_P2.50mm_Vertical
R29, R31: 10k; R_0805_2012Metric_Pad1.20x1.40mm_HandSolder
Tirette1: tirette_TP; S275146R

Connections:
GND: J20.1; also elsewhere on the board
unnamed: J20.2, R29.2
TP3.3V_1_Power: R29.1, R31.2; also elsewhere on the board
Tirette_indic: R31.1, Tirette1.1; also elsewhere on the board

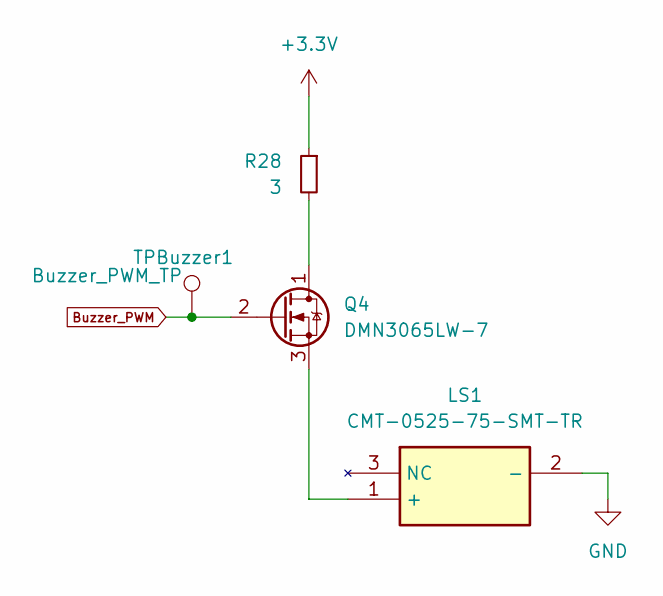
[picture p27: schematic Buzzer_circuit.kicad_sch]

Parts:
LS1: CMT-0525-75-SMT-TR; CMT052575SMTTR; Manufacturer_Part_Number CMT-0525-75-SMT-TR; Mouser Part Number 490-CMT-0525-75SMTTR
Q4: DMN3065LW-7; SOT65P210X110-3N
R28: 3; R_0805_2012Metric_Pad1.20x1.40mm_HandSolder
TPBuzzer1: Buzzer_PWM_TP; S275146R

Connections:
Buzzer_PWM: Q4.2 (G), TPBuzzer1.1; also elsewhere on the board
GND: LS1.2 (-); also elsewhere on the board
unnamed: LS1.1 (+), Q4.3 (S)
unnamed: Q4.1 (D), R28.2
TP3.3V_1_Power: R28.1; also elsewhere on the board

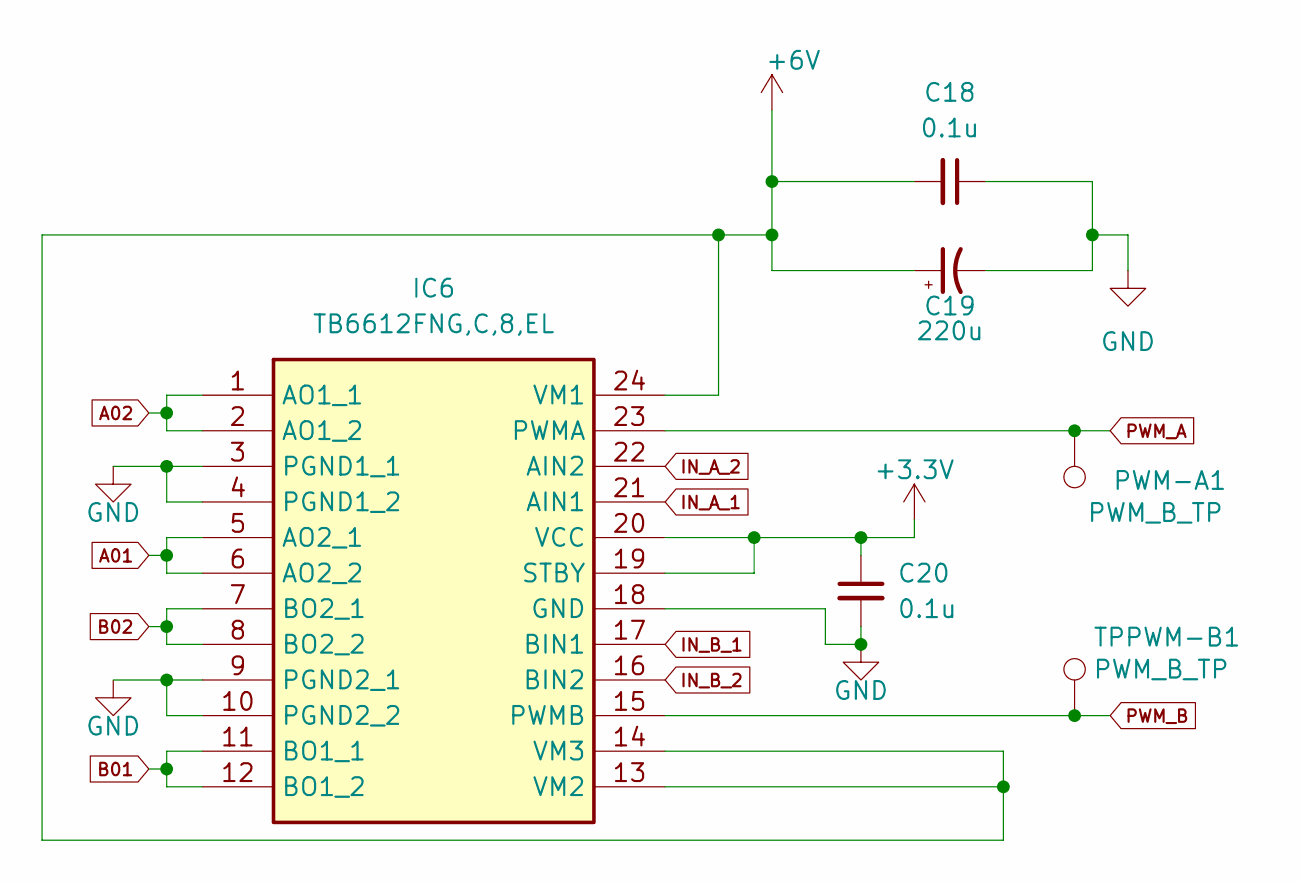
[picture p28: schematic TB6612FNG.kicad_sch]

Parts:
C18, C20: 0.1u; C_0805_2012Metric_Pad1.18x1.45mm_HandSolder
C19: 220u; CAPPM3528X210N
IC6: TB6612FNG,C,8,EL; SOP65P760X160-24N; Manufacturer_Part_Number TB6612FNG,C,8,EL; Mouser Part Number 757-TB6612FNGC8EL
PWM-A1: PWM_B_TP; S275146R
TPPWM-B1: PWM_B_TP; S275146R

Connections:
+6V: C18.2, C19.1, IC6.13 (VM2), IC6.14 (VM3), IC6.24 (VM1); also elsewhere on the board
A01: IC6.5 (AO2_1), IC6.6 (AO2_2); also elsewhere on the board
A02: IC6.1 (AO1_1), IC6.2 (AO1_2); also elsewhere on the board
B01: IC6.11 (BO1_1), IC6.12 (BO1_2); also elsewhere on the board
B02: IC6.7 (BO2_1), IC6.8 (BO2_2); also elsewhere on the board
GND: C18.1, C19.2, C20.2, IC6.3 (PGND1_1), IC6.4 (PGND1_2), IC6.9 (PGND2_1), IC6.10 (PGND2_2), IC6.18 (GND); also elsewhere on the board
IN_A_1: IC6.21 (AIN1); also elsewhere on the board
IN_A_2: IC6.22 (AIN2); also elsewhere on the board
IN_B_1: IC6.17 (BIN1); also elsewhere on the board
IN_B_2: IC6.16 (BIN2); also elsewhere on the board
PWM_A: IC6.23 (PWMA), PWM-A1.1; also elsewhere on the board
PWM_B: IC6.15 (PWMB), TPPWM-B1.1; also elsewhere on the board
TP3.3V_1_Power: C20.1, IC6.19 (STBY), IC6.20 (VCC); also elsewhere on the board

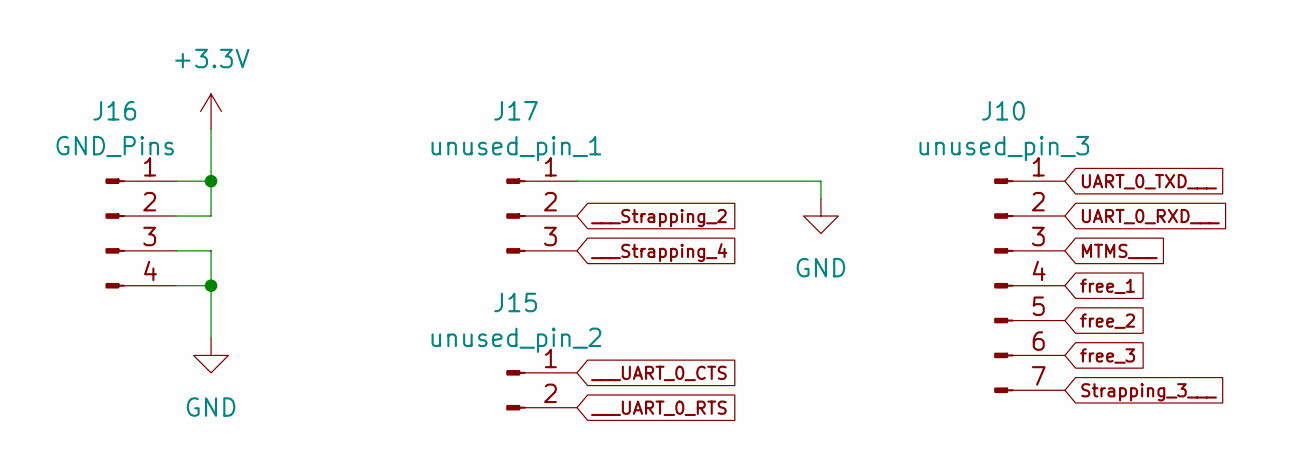
[picture p29: schematic pins.kicad_sch]

Parts:
J10: unused_pin_3; PinSocket_1x07_P2.54mm_Vertical
J15: unused_pin_2; PinSocket_1x02_P2.54mm_Vertical
J16: GND_Pins; PinSocket_1x04_P2.54mm_Vertical
J17: unused_pin_1; PinSocket_1x03_P2.54mm_Vertical

Connections:
GND: J16.3, J16.4, J17.1; also elsewhere on the board
MTMS___: J10.3; also elsewhere on the board
Strapping_3___: J10.7; also elsewhere on the board
TP3.3V_1_Power: J16.1, J16.2; also elsewhere on the board
UART_0_RXD___: J10.2; also elsewhere on the board
UART_0_TXD___: J10.1; also elsewhere on the board
___Strapping_2: J17.2; also elsewhere on the board
___Strapping_4: J17.3; also elsewhere on the board
___UART_0_CTS: J15.1; also elsewhere on the board
___UART_0_RTS: J15.2; also elsewhere on the board
free_1: J10.4; also elsewhere on the board
free_2: J10.5; also elsewhere on the board
free_3: J10.6; also elsewhere on the board

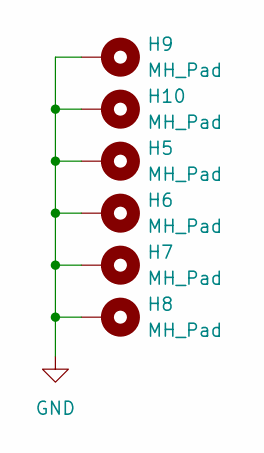
[picture p30: schematic More_MH.kicad_sch]

Parts:
H5, H6, H7, H8, H9, H10: MH_Pad; MountingHole_2.2mm_M2_Pad_Via

Connections:
GND: H5.1, H6.1, H7.1, H8.1, H9.1, H10.1; also elsewhere on the board

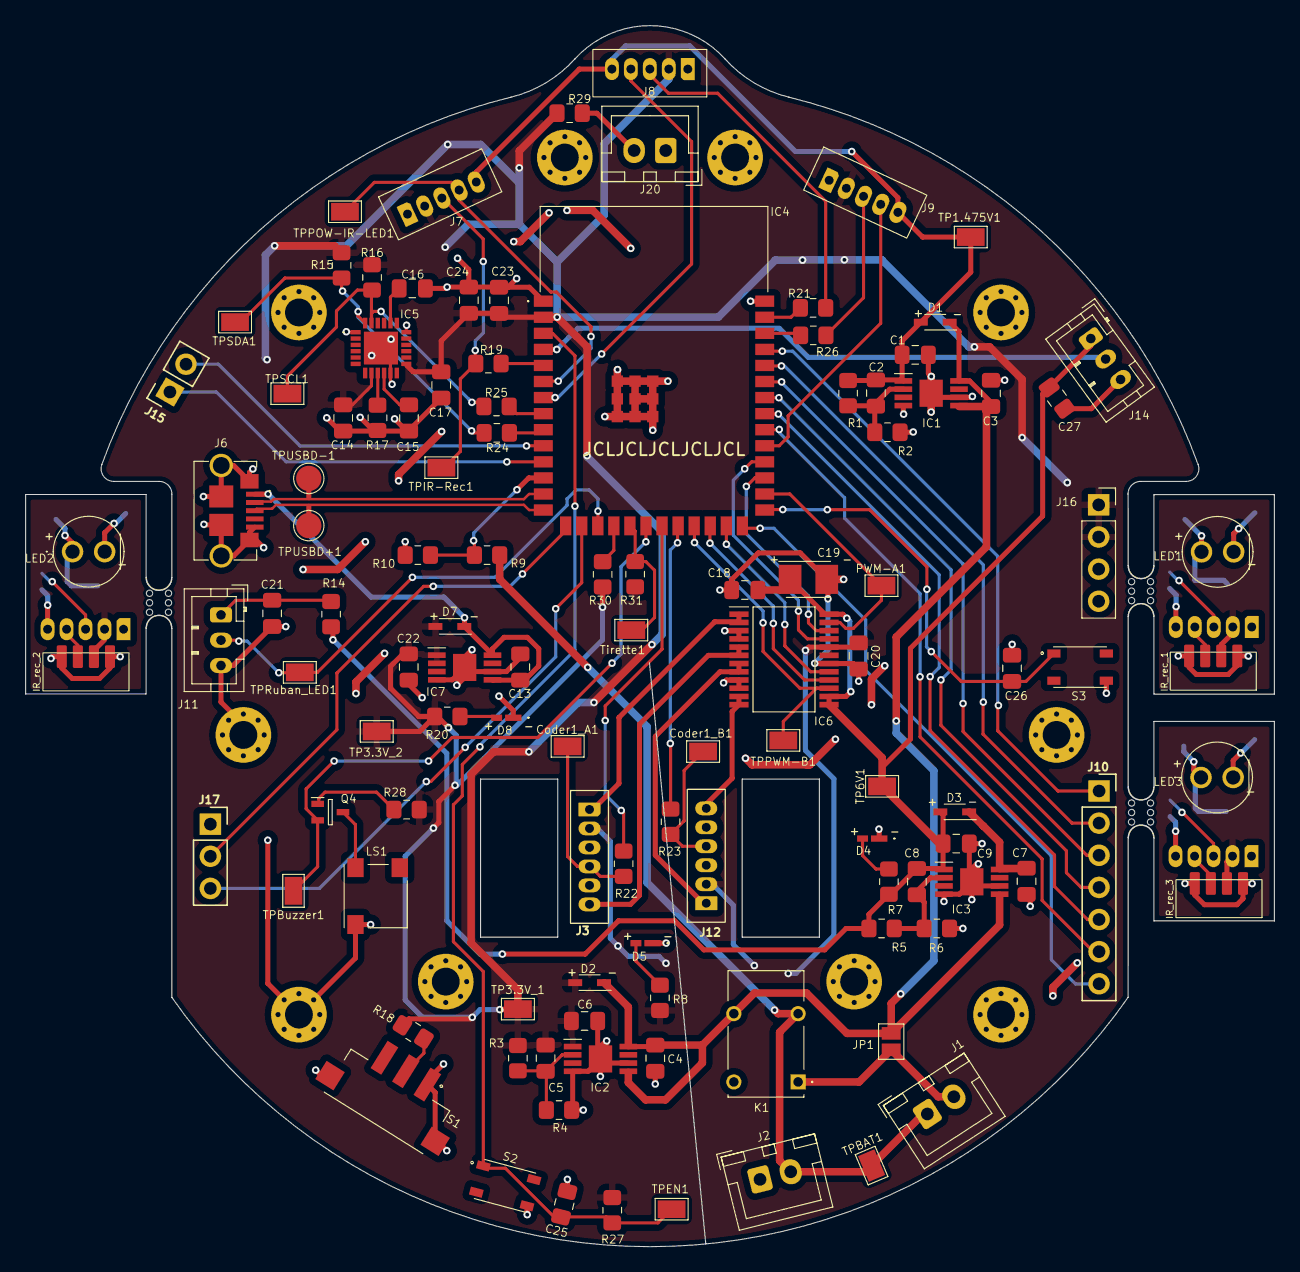
[picture p31: board PAMI-Power_Board.kicad_pcb from above]

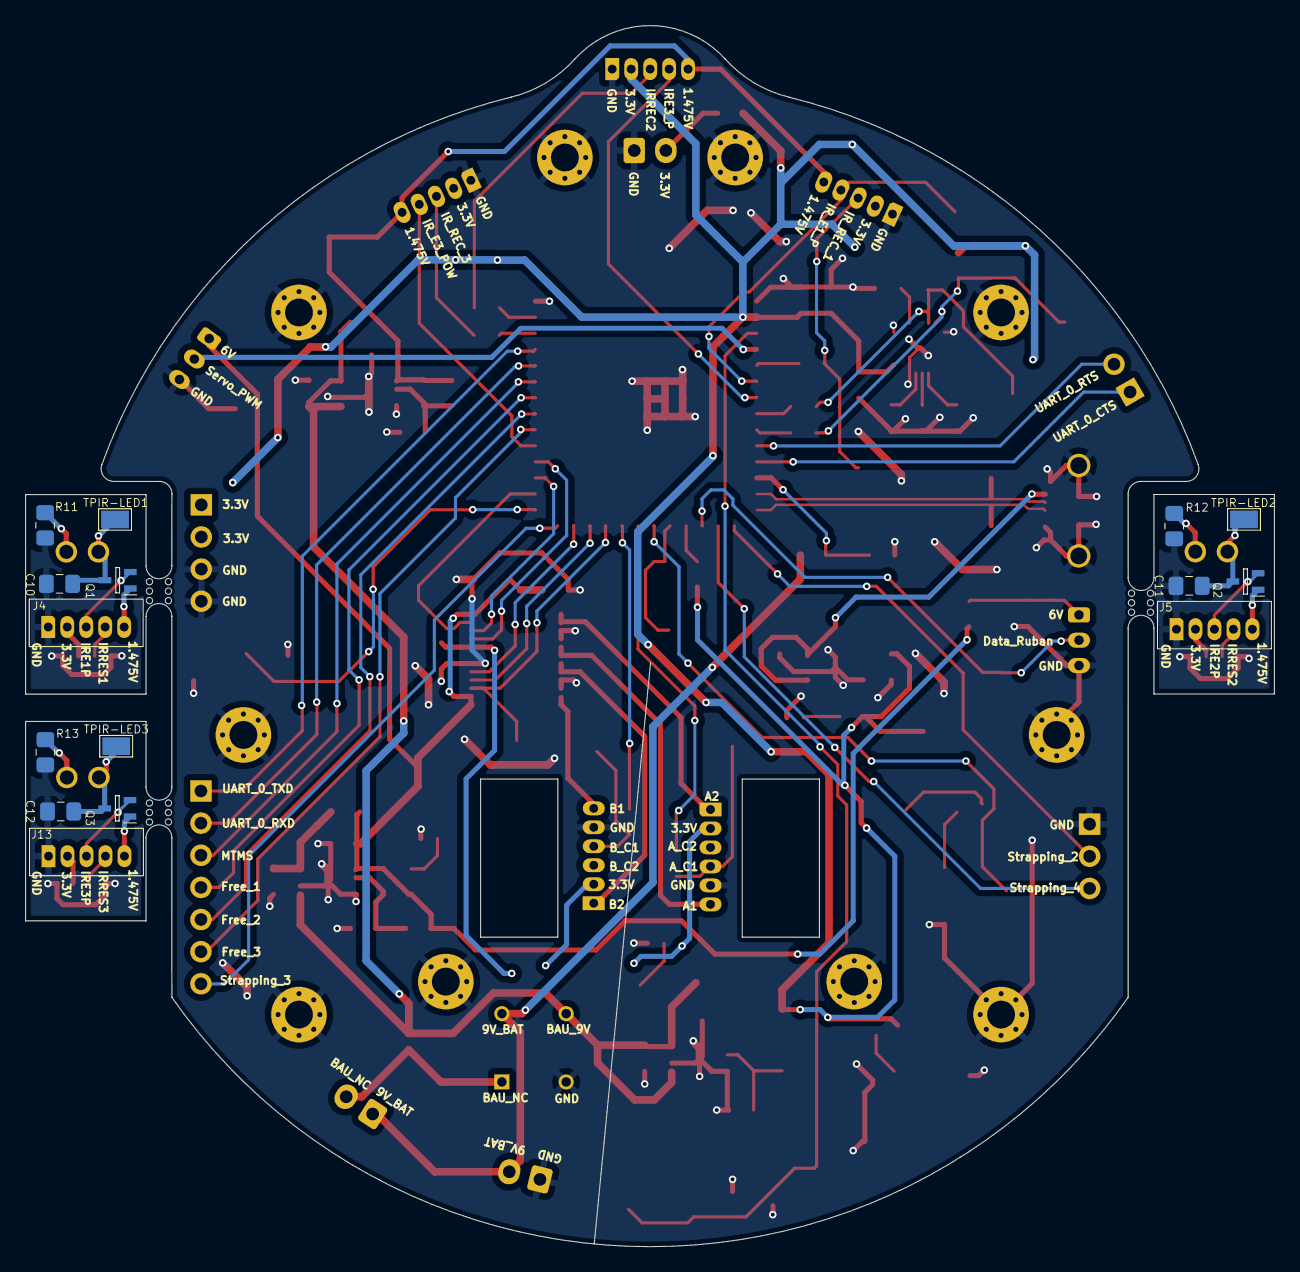
[picture p32: board PAMI-Power_Board.kicad_pcb from below]

Board: 2 copper layers, 98.7 x 96.5 mm, 141 parts (15 on the bottom side), 76 nets.

Other parts of the board:
mouse-bite-2mm-slot, mouse-bite-2mm-slot#2, mouse-bite-2mm-slot#3: VAL**; mouse-bite-2mm-slot
