emericarhantdev/micro_ROSbot/(notices)

Notices in the files:
Specific_symbols_and_footprints/Switch_buttons/LIB_SS312SAH4/SS312SAH4/3D/SS312SAH4.stp:
author */ ('License CC BY-ND 4.0'),
